nathannegron1/analog_synthesizer/Media/angled-view.jpg

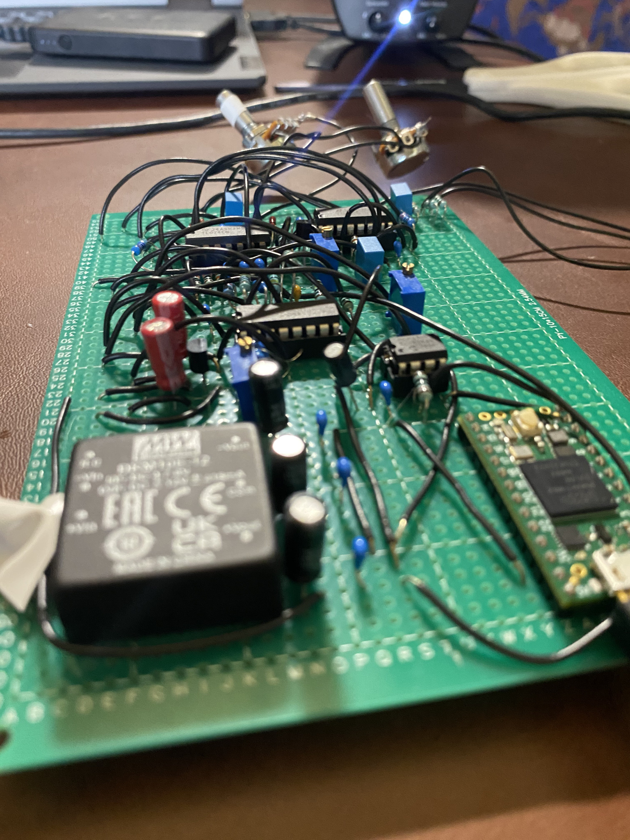
Media/angled-view.jpg
