nathannegron1/analog_synthesizer/Media/board-and-controls.jpg

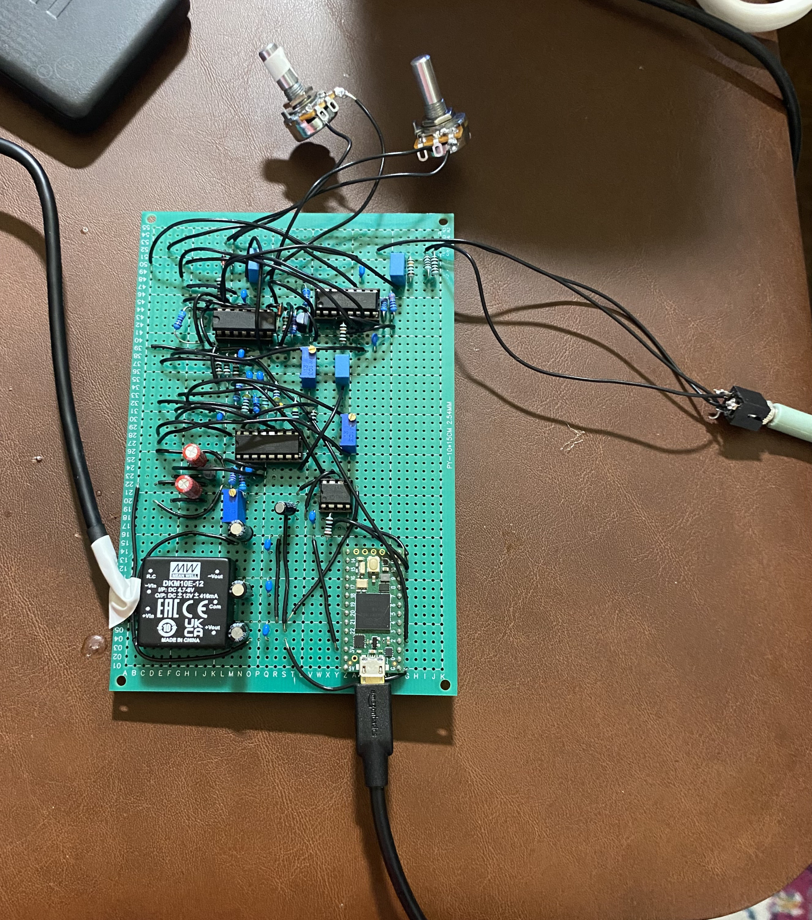
Media/board-and-controls.jpg
