nathannegron1/analog_synthesizer/Hardware/schematic.pdf

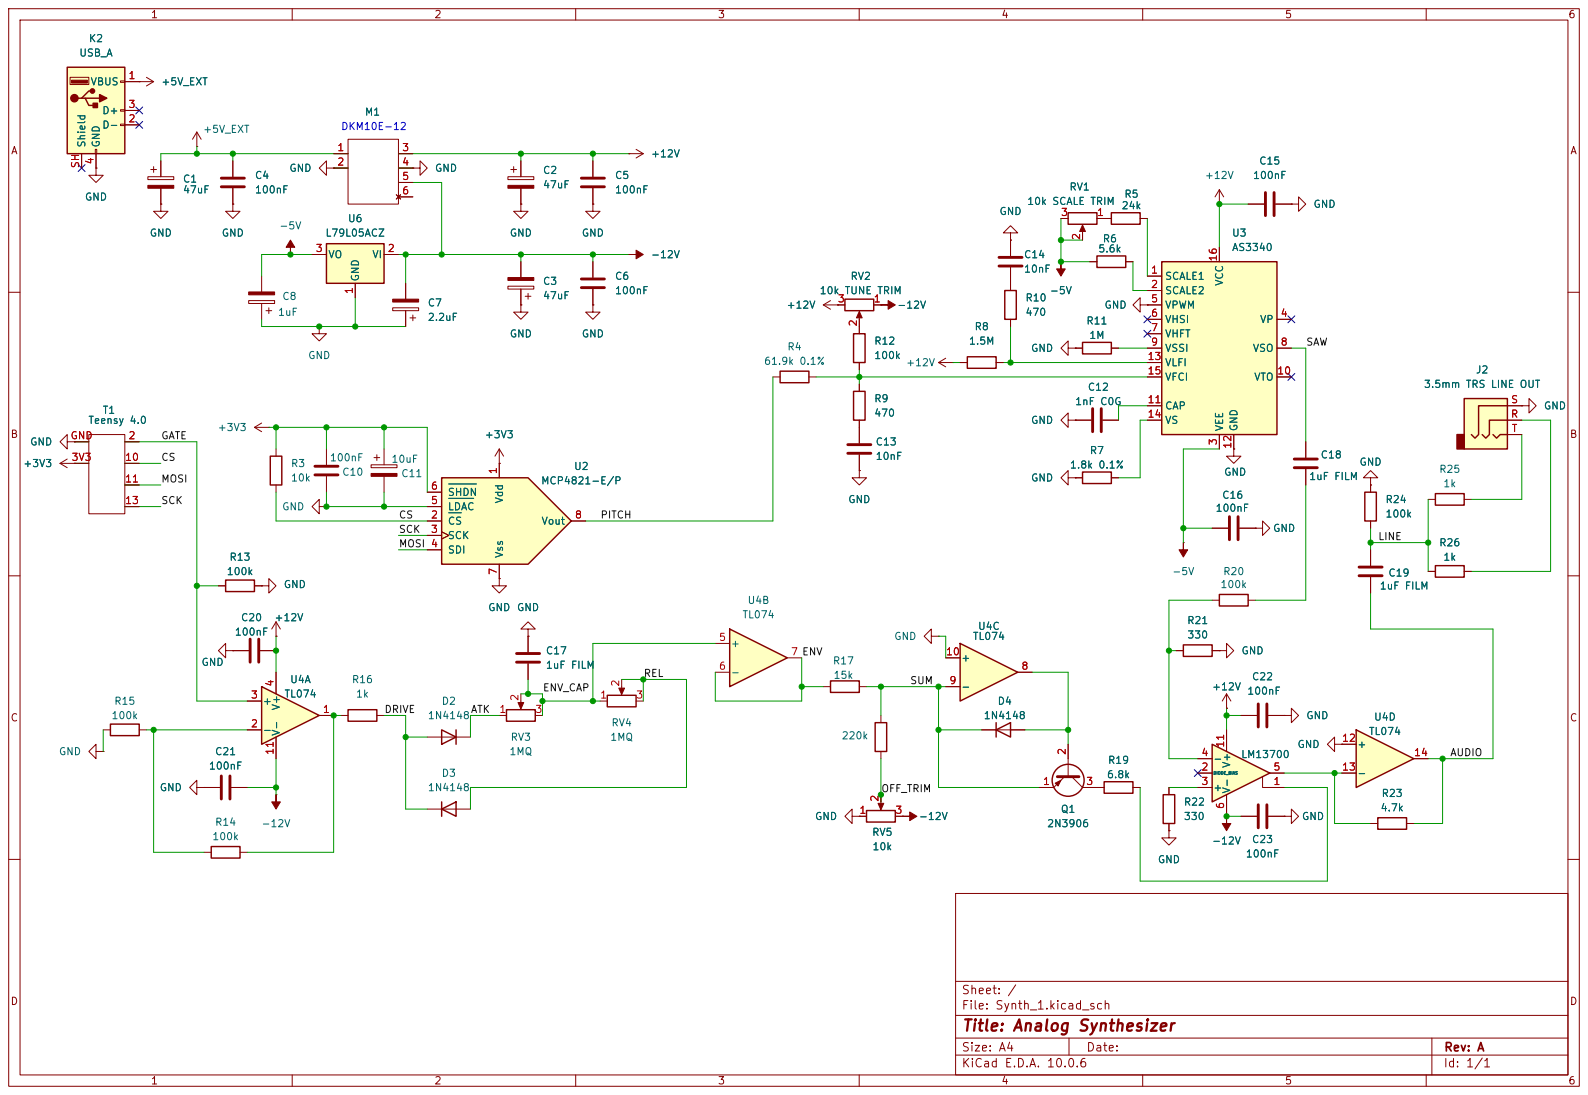
[picture p6: page 1]

Size: A4 | Rev: A
KiCad E.D.A. 10.0.6 | Id: 1/1
