nathannegron1/analog_synthesizer/Hardware/perfboard_sketch.pdf

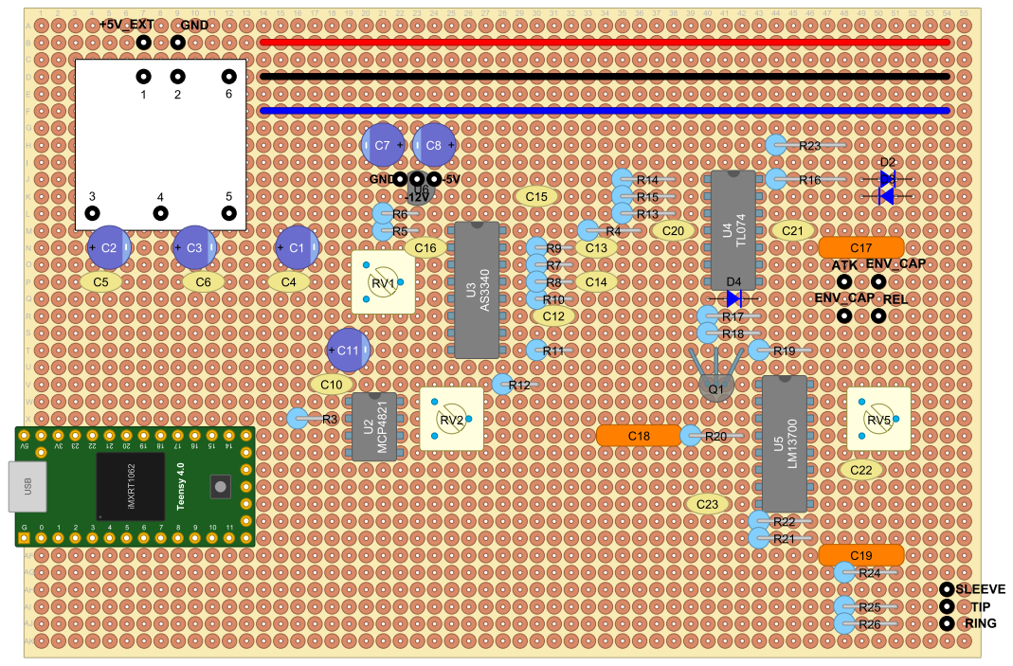
[picture p7: page 1]
